GoncaloMark/Turbina/Readme.md

# Turbina '23

Componente Hardware e Software para Turbinas Tesup carregarem baterias de 12V.
