GoncaloMark/Turbina/Hardware/Placa_CAD/TURBINADA.kicad_pcb

## KiCad design Hardware/Placa_CAD/TURBINADA.kicad_pcb (2023-04-24)

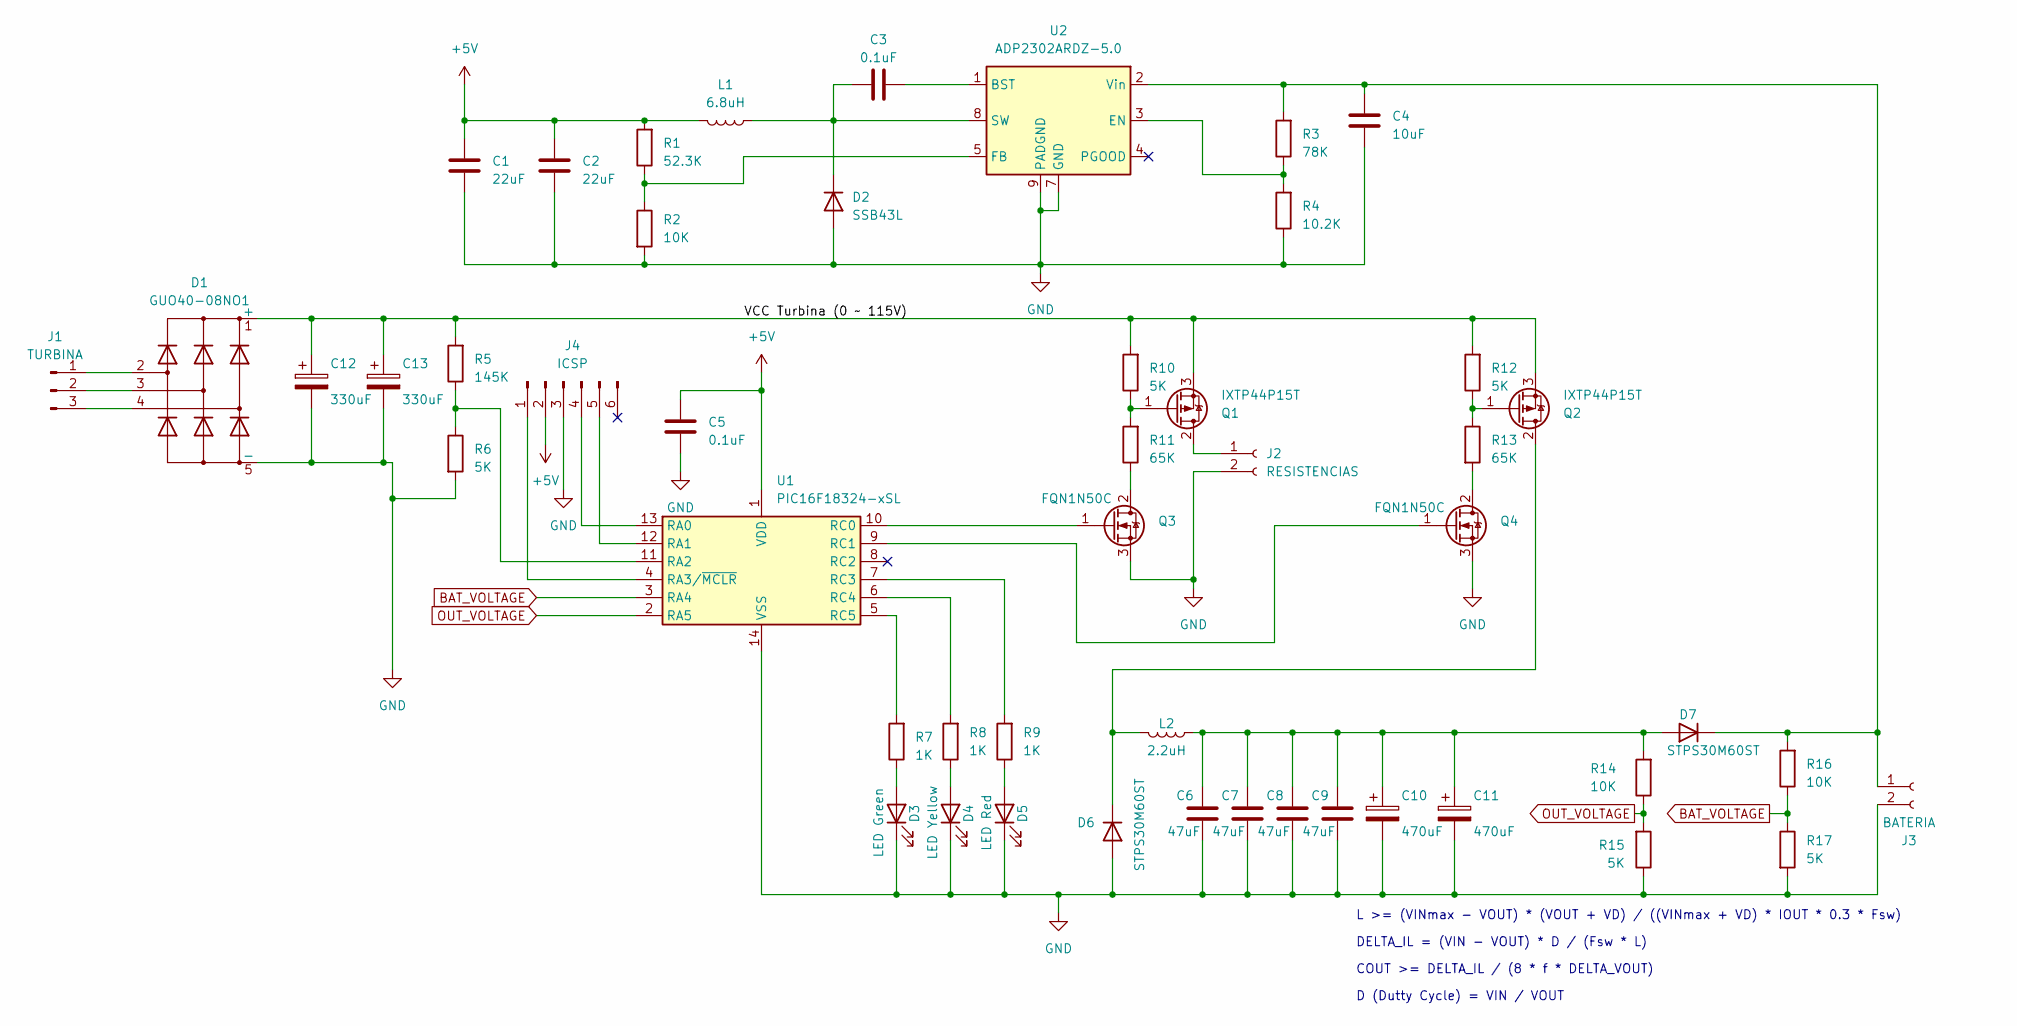
[picture p1: schematic TURBINADA.kicad_sch]

Parts:
C1, C2: 22uF; C_Disc_D7.5mm_W5.0mm_P5.00mm; Part FG20X7R1C226MRT00
C3, C5: 0.1uF; C_Disc_D6.0mm_W4.4mm_P5.00mm; Part K104K15X7RF53H5
C4: 10uF; C_Disc_D6.0mm_W4.4mm_P5.00mm; Part FG24X7R1A106KRT06
C6, C7, C8, C9: 47uF; C_Radial_D6.3mm_H5.0mm_P2.50mm; Part FG16X5R1E476MRT06
C10, C11: 470uF; CP_Radial_D13.0mm_P5.00mm; Part ESK477M063AL4AA
C12, C13: 330uF; CP_Radial_D18.0mm_P7.50mm; Part UVY2D331MHD
D1: GUO40-08NO1; Diode_Bridge_IXYS_GUFP; Part GUO40-08NO1
D2: SSB43L; D_SMB_Handsoldering; Part SSB43L
D3: LED Green; LED_D4.0mm; Part C4SMA-GGY-CU2W37A1
D4: LED Yellow; LED_D4.0mm; Part SSL-LX3054OD
D5: LED Red; LED_D4.0mm; Part C4SMA-RGY-CS4V1BB1
D6, D7: STPS30M60ST; TO-220-3_Vertical; Part STPS30M60ST
J1: TURBINA; PhoenixContact_GMSTBA_2,5_3-G_1x03_P7.50mm_Horizontal; Part 1988118
J2: RESISTENCIAS; PhoenixContact_MSTBA_2,5_2-G_1x02_P5.00mm_Horizontal; Part 1987724
J3: BATERIA; TerminalBlock_RND_205-00241_1x02_P10.16mm_Horizontal; Part 1017526
J4: ICSP; PinSocket_1x06_P2.54mm_Vertical
L1: 6.8uH; L_Bourns_SRP1038C_10.0x10.0mm; Part CLF10040T-6R8N-D
L2: 2.2uH; IHXL1500VZEB2R2M51; Part IHXL1500VZEB2R2M51
Q1, Q2: IXTP44P15T; TO-220-3_Vertical; Part IXTP44P15T
Q3, Q4: FQN1N50C; TO-92; Part FQN1N50C
R1: 52.3K; R_Axial_DIN0207_L6.3mm_D2.5mm_P7.62mm_Horizontal; Part MFR-25FBF52-52K3
R2, R14, R16: 10K; R_Axial_DIN0207_L6.3mm_D2.5mm_P7.62mm_Horizontal; Part CMF5510K000FKEK
R3: 78K; R_Axial_DIN0207_L6.3mm_D2.5mm_P7.62mm_Horizontal; Part CMF5578K700FHEB
R4: 10.2K; R_Axial_DIN0207_L6.3mm_D2.5mm_P7.62mm_Horizontal; Part CMF5510K200FHEB
R5: 145K; R_Axial_DIN0207_L6.3mm_D2.5mm_P7.62mm_Horizontal; Part CMF55145K00BER6
R6, R10, R12, R15, R17: 5K; R_Axial_DIN0207_L6.3mm_D2.5mm_P7.62mm_Horizontal; Part CMF555K0000BEEK
R7, R8, R9: 1K; R_Axial_DIN0207_L6.3mm_D2.5mm_P7.62mm_Horizontal; Part MF1/4LCT52R102J
R11, R13: 65K; R_Axial_DIN0207_L6.3mm_D2.5mm_P7.62mm_Horizontal; Part CMF5565K700BHEK
U1: PIC16F18324-xSL; DIP-14_W10.16mm; Part PIC16F18324
U2: ADP2302ARDZ-5.0; SOIC-8-1EP_3.9x4.9mm_P1.27mm_EP2.29x3mm; Part ADP2302ARDZ-5.0

Connections:
+5V: C1.2, C2.2, C5.2, J4.2, L1.2, R1.2, U1.1 (VDD)
/VCC Turbina (0 ~ 115V): C12.1, C13.1, D1.1 (+), Q1.3 (S), Q2.3 (S), R5.2, R10.2, R12.2
BAT_VOLTAGE: R16.1, R17.1, U1.3 (RA4)
GND: C1.1, C2.1, C4.1, C5.1, C6.2, C7.2, C8.2, C9.2, C10.2, C11.2, C12.2, C13.2, D1.5 (-), D2.2 (A), D3.1 (K), D4.1 (K), D5.1 (K), D6.1 (A), D6.3 (A), J2.2, J3.2, J4.3, Q3.3 (S), Q4.3 (S), R2.2, R4.1, R6.2, R15.1, R17.2, U1.14 (VSS), U2.7 (GND), U2.9 (PADGND)
unnamed: C6.1, C7.1, C8.1, C9.1, C10.1, C11.1, D7.1 (A), D7.3 (A), L2.1, R14.2
unnamed: C3.1, D2.1 (K), L1.1, U2.8 (SW)
unnamed: D3.2 (A), R7.1
unnamed: D4.2 (A), R8.1
unnamed: D5.2 (A), R9.1
unnamed: D6.2 (K), L2.2, Q2.2 (D)
unnamed: C4.2, D7.2 (K), J3.1, R3.2, R16.2, U2.2 (Vin)
unnamed: D1.2, J1.1
unnamed: D1.3, J1.2
unnamed: D1.4, J1.3
unnamed: J2.1, Q1.2 (D)
unnamed: J4.1, U1.4 (RA3/~MCLR)
unnamed: J4.4, U1.13 (RA0)
unnamed: J4.5, U1.12 (RA1)
unnamed: Q1.1 (G), R10.1, R11.2
unnamed: Q2.1 (G), R12.1, R13.1
unnamed: Q3.2 (D), R11.1
unnamed: Q3.1 (G), U1.10 (RC0)
unnamed: Q4.2 (D), R13.2
unnamed: Q4.1 (G), U1.9 (RC1)
unnamed: R5.1, R6.1, U1.11 (RA2)
unnamed: R9.2, U1.7 (RC3)
unnamed: R8.2, U1.6 (RC4)
unnamed: R7.2, U1.5 (RC5)
unnamed: C3.2, U2.1 (BST)
unnamed: R3.1, R4.2, U2.3 (EN)
unnamed: R1.1, R2.1, U2.5 (FB)
OUT_VOLTAGE: R14.1, R15.2, U1.2 (RA5)

Notes on the sheet:
COUT >= DELTA_IL / (8 * f * DELTA_VOUT)
L >= (VINmax - VOUT) * (VOUT + VD) / ((VINmax + VD) * IOUT * 0.3 * Fsw)
DELTA_IL = (VIN - VOUT) * D / (Fsw * L)
D (Dutty Cycle) = VIN / VOUT

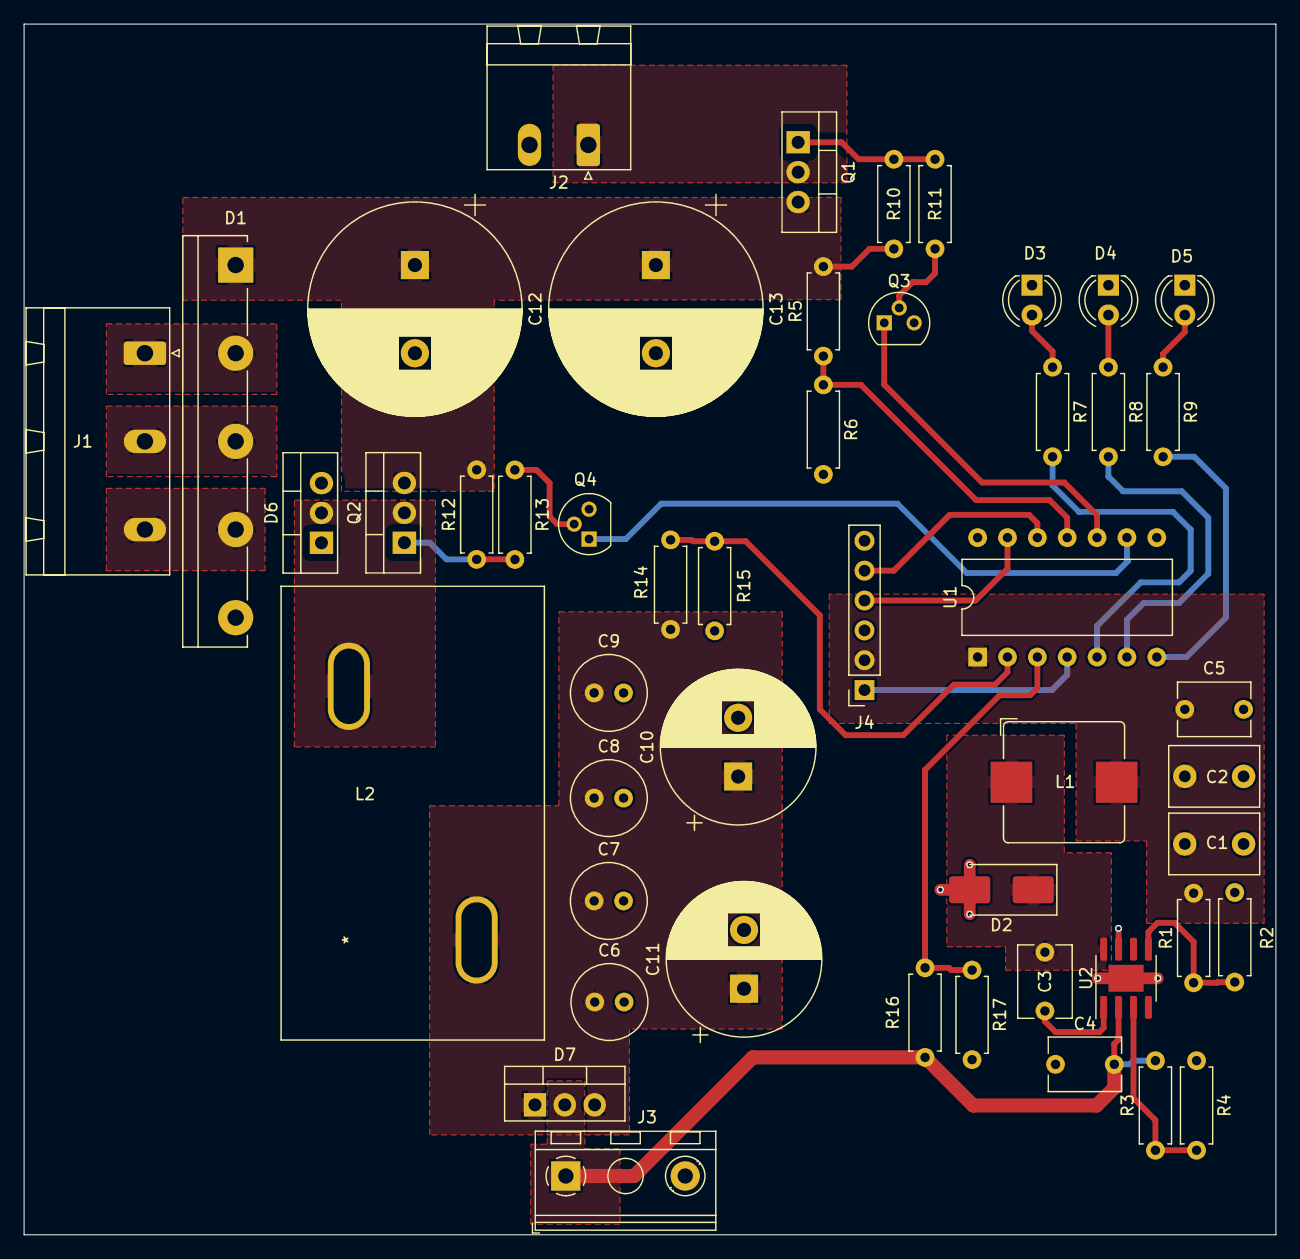
[picture p2: board TURBINADA.kicad_pcb from above]

Board: 6 copper layers, 106.5 x 103.0 mm, 49 parts (0 on the bottom side), 32 nets.
