GoncaloMark/Turbina/(commit log)

2023-02-09 First commit, KiCAD (Hardware)
    [TURBINADA.kicad_pcb, TURBINADA.kicad_sch]
2023-02-09 PCB Design (missing board outline)
    [TURBINADA.kicad_pcb]
2023-03-03 Selected transistor components in schematic
    [TURBINADA.kicad_sch]
2023-03-15 Selected a few more components and footprints
    [TURBINADA.kicad_sch]
2023-03-17 All components selected except for the output coil and capacitor
    [TURBINADA.kicad_sch]
2023-03-28 Selected all components. Started PCB drawing
    [TURBINADA.kicad_pcb, TURBINADA.kicad_sch]
2023-03-29 Finished board layout
    [TURBINADA.kicad_pcb, TURBINADA.kicad_sch]
2023-03-29 Fixed a BAT connector track in the layout
    [TURBINADA.kicad_pcb]
2023-03-29 Changed coil footprint
    [TURBINADA.kicad_pcb, TURBINADA.kicad_sch]
2023-03-29 Corrected some part numbers
    [TURBINADA.kicad_sch]
